partypancake8/4square_production/hardware/bom.csv

Comment | Designator | Footprint | LCSC Part #
PCA9548APW | U1 | TSSOP-24_4.4x7.8mm_P0.65mm | C130026
AP2112K-3.3 | U2 | SOT-23-5 | C51118
DS3231MZ+TRL | U4 | SOIC-8_3.9x4.9mm_P1.27mm | C107410
SHT31-DIS-B | U5 | Sensirion_DFN-8-1EP_2.5x2.5mm_P0.5mm_EP1.1x1.7mm | C80862
SN74AHCT1G125DBVR | U6 | SOT-23-5 | C7484
SRV05-4 | U7 | SOT-23-6 | C85364
GL5050RGB01H-W | D2 | LED_WS2812B_PLCC4_5.0x5.0mm_P3.2mm | C51933368
SMAJ5.0A-13-F | D3 | D_SMA | C87074
GL5050RGB01H-W | D4 | LED_WS2812B_PLCC4_5.0x5.0mm_P3.2mm | C51933368
GL5050RGB01H-W | D5 | LED_WS2812B_PLCC4_5.0x5.0mm_P3.2mm | C51933368
PolyFuse 750mA 1206L075/16WR | F1 | Fuse_1206_3216Metric | C371166
PT17-21C/L41/TR8 phototransistor | R7 | R_0805_2012Metric | C100090
1k 0603 | R8 | R_0603_1608Metric | C21190
1k 0603 | R9 | R_0603_1608Metric | C21190
1k 0603 | R10 | R_0603_1608Metric | C21190
1k 0603 | R11 | R_0603_1608Metric | C21190
470R 0603 | R12 | R_0603_1608Metric | C23179
10k 0603 1% | R13 | R_0603_1608Metric | C25804
10k 0603 1% | R14 | R_0603_1608Metric | C25804
100n 0603 | C1 | C_0603_1608Metric | C14663
10u 0805 | C2 | C_0805_2012Metric | C15850
10u 0805 | C3 | C_0805_2012Metric | C15850
10u 0805 | C4 | C_0805_2012Metric | C15850
100n 0603 | C5 | C_0603_1608Metric | C14663
100n 0603 | C6 | C_0603_1608Metric | C14663
100n 0603 | C7 | C_0603_1608Metric | C14663
100n 0603 | C8 | C_0603_1608Metric | C14663
22u 0805 | C9 | C_0805_2012Metric | C45783
100n 0603 | C10 | C_0603_1608Metric | C14663
100n 0603 | C11 | C_0603_1608Metric | C14663
100n 0603 | C12 | C_0603_1608Metric | C14663
100n 0603 | C13 | C_0603_1608Metric | C14663
100n 0603 | C14 | C_0603_1608Metric | C14663
22u 0805 | C15 | C_0805_2012Metric | C45783
100n 0603 | C16 | C_0603_1608Metric | C14663
100n 0603 | C17 | C_0603_1608Metric | C14663
10u 0805 | C18 | C_0805_2012Metric | C15850
