partypancake8/4square_production/case/4square-acrylic-back-reference.stl

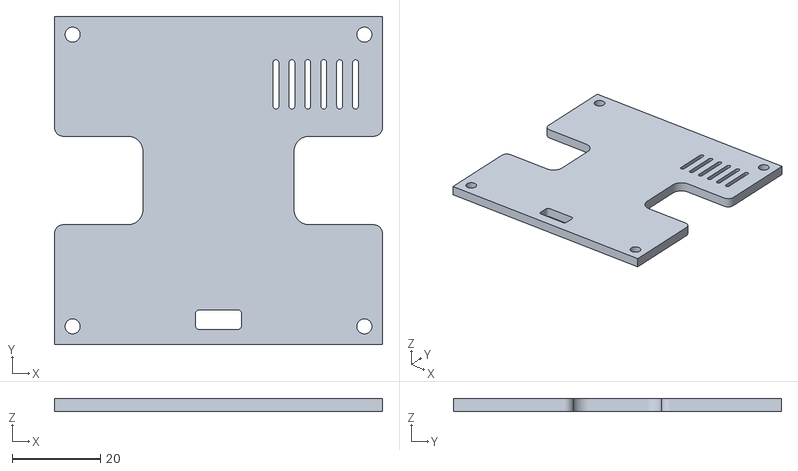
[picture p16: CAD file, 2026-10-29]
case/4square-acrylic-back-reference.stl
74.2 x 74.2 x 3.00
