partypancake8/4square_production/case/4square-shell.stl

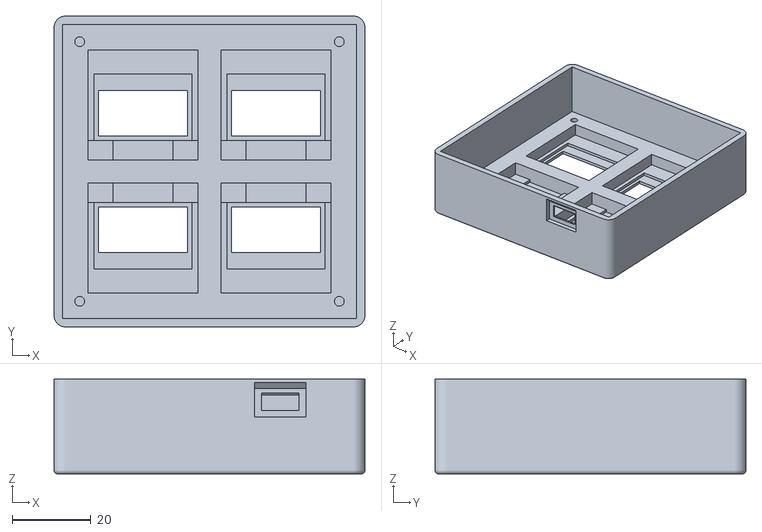
[picture p17: CAD file, 2026-10-29]
case/4square-shell.stl
79.1 x 79.1 x 24.1
