partypancake8/4square_production/case/4square-standoff-frame.stl

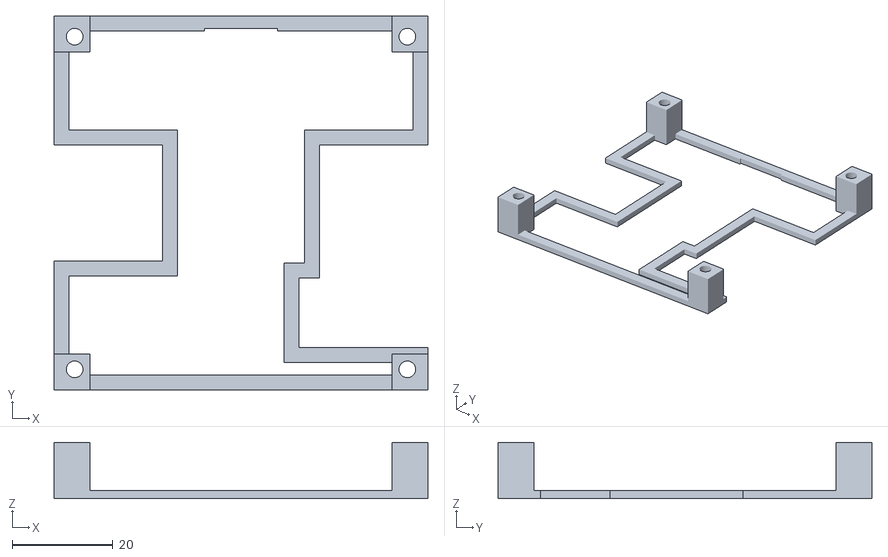
[picture p18: CAD file, 2026-10-29]
case/4square-standoff-frame.stl
74.2 x 74.2 x 11.1
