partypancake8/4square_production/case/4square-retainer-half-b.stl

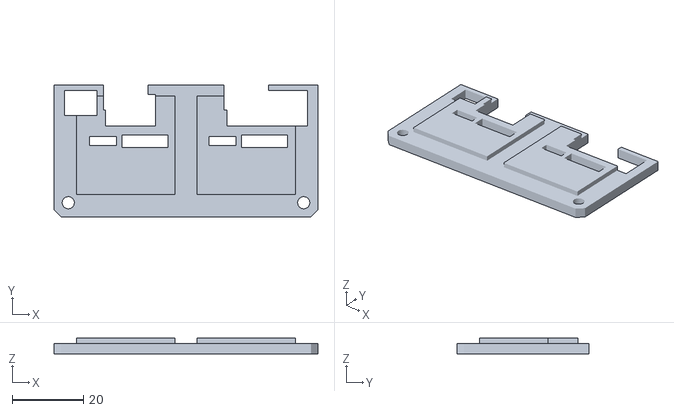
[picture p19: CAD file, 2026-10-29]
case/4square-retainer-half-b.stl
74.0 x 37.0 x 4.48
