partypancake8/4square_production/case/4square-acrylic-back.dxf

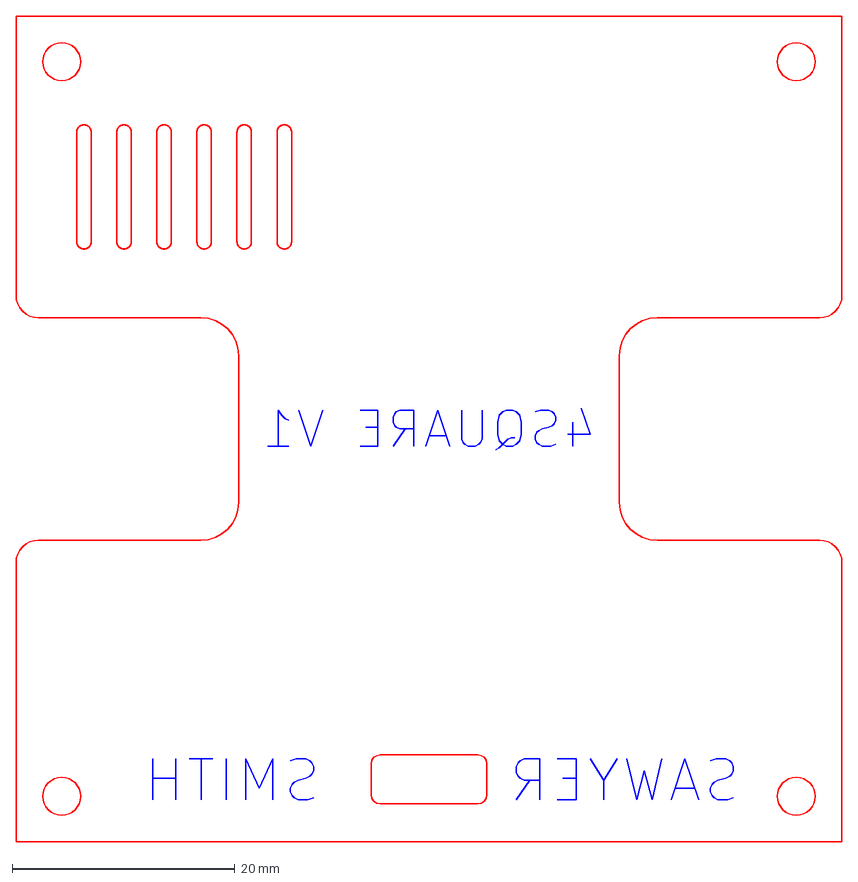
[picture p20: CAD file, 2026-10-29]
case/4square-acrylic-back.dxf
74.2 x 74.2 mm
