partypancake8/4square_production/case/4square-printed-back.stl

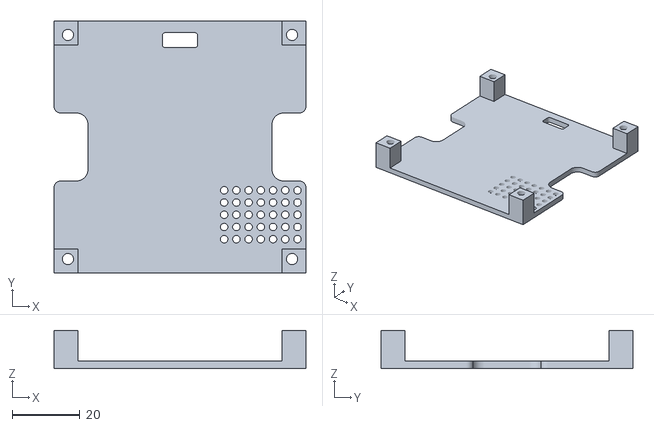
[picture p21: CAD file, 2026-10-29]
case/4square-printed-back.stl
74.2 x 74.2 x 11.2
