partypancake8/4square_production/(list of files, cad)

Other CAD files:
case/4square-retainer-half-a.stl
