partypancake8/4square_production/hardware/4square-revO-board.pdf

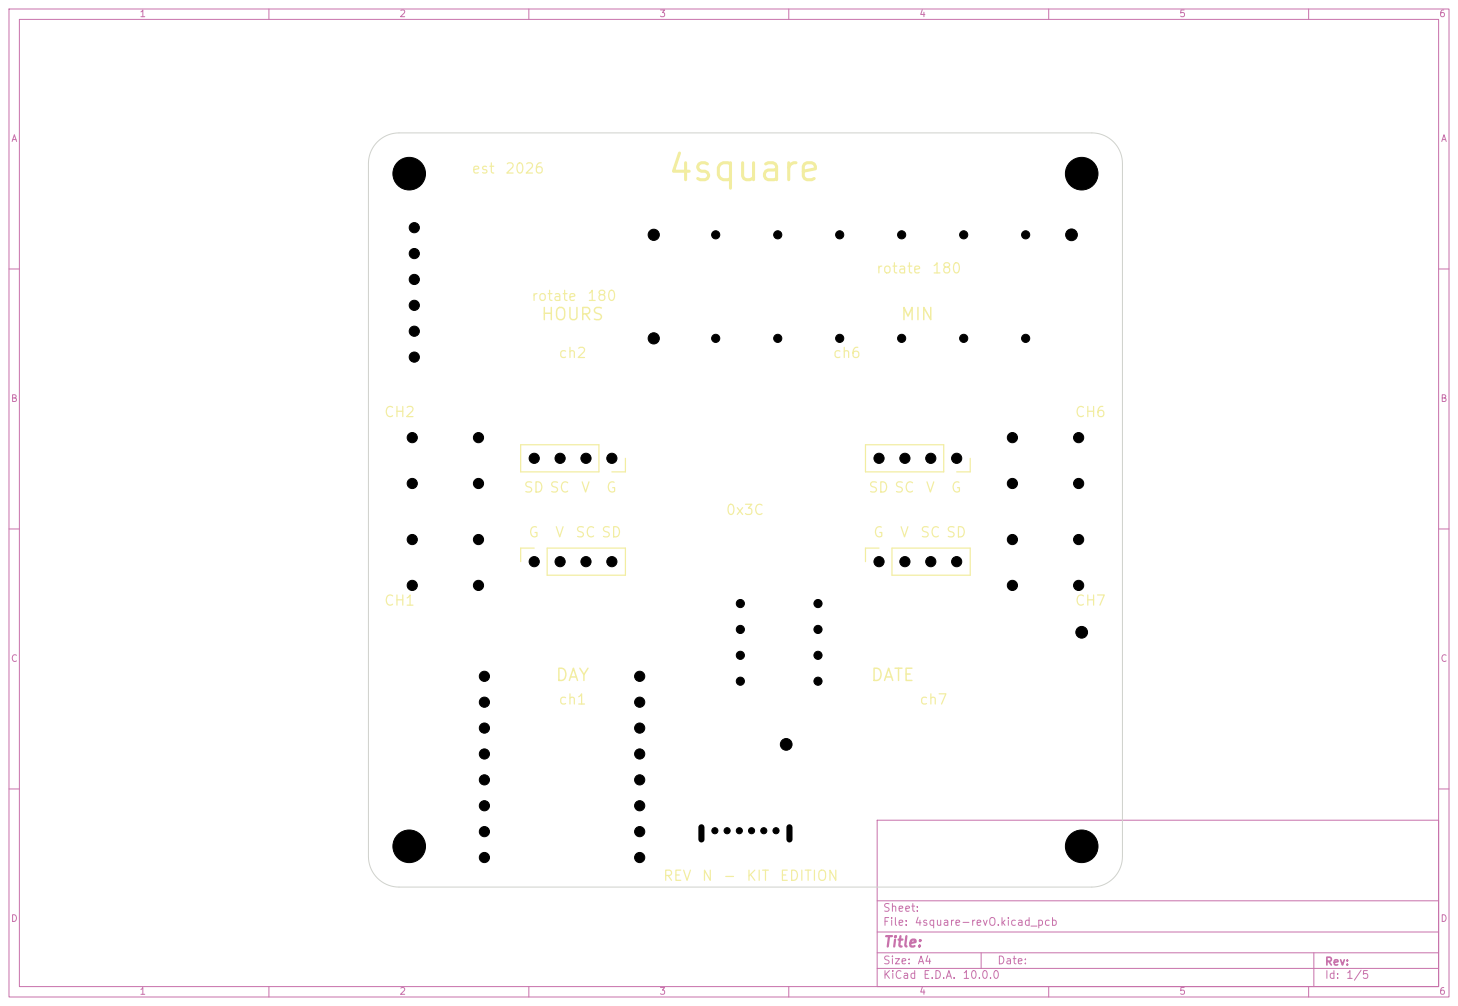
[picture p23: page 1]

Size: A4 | Rev:
KiCad E.D.A. 10.0.0 | Id: 1/5

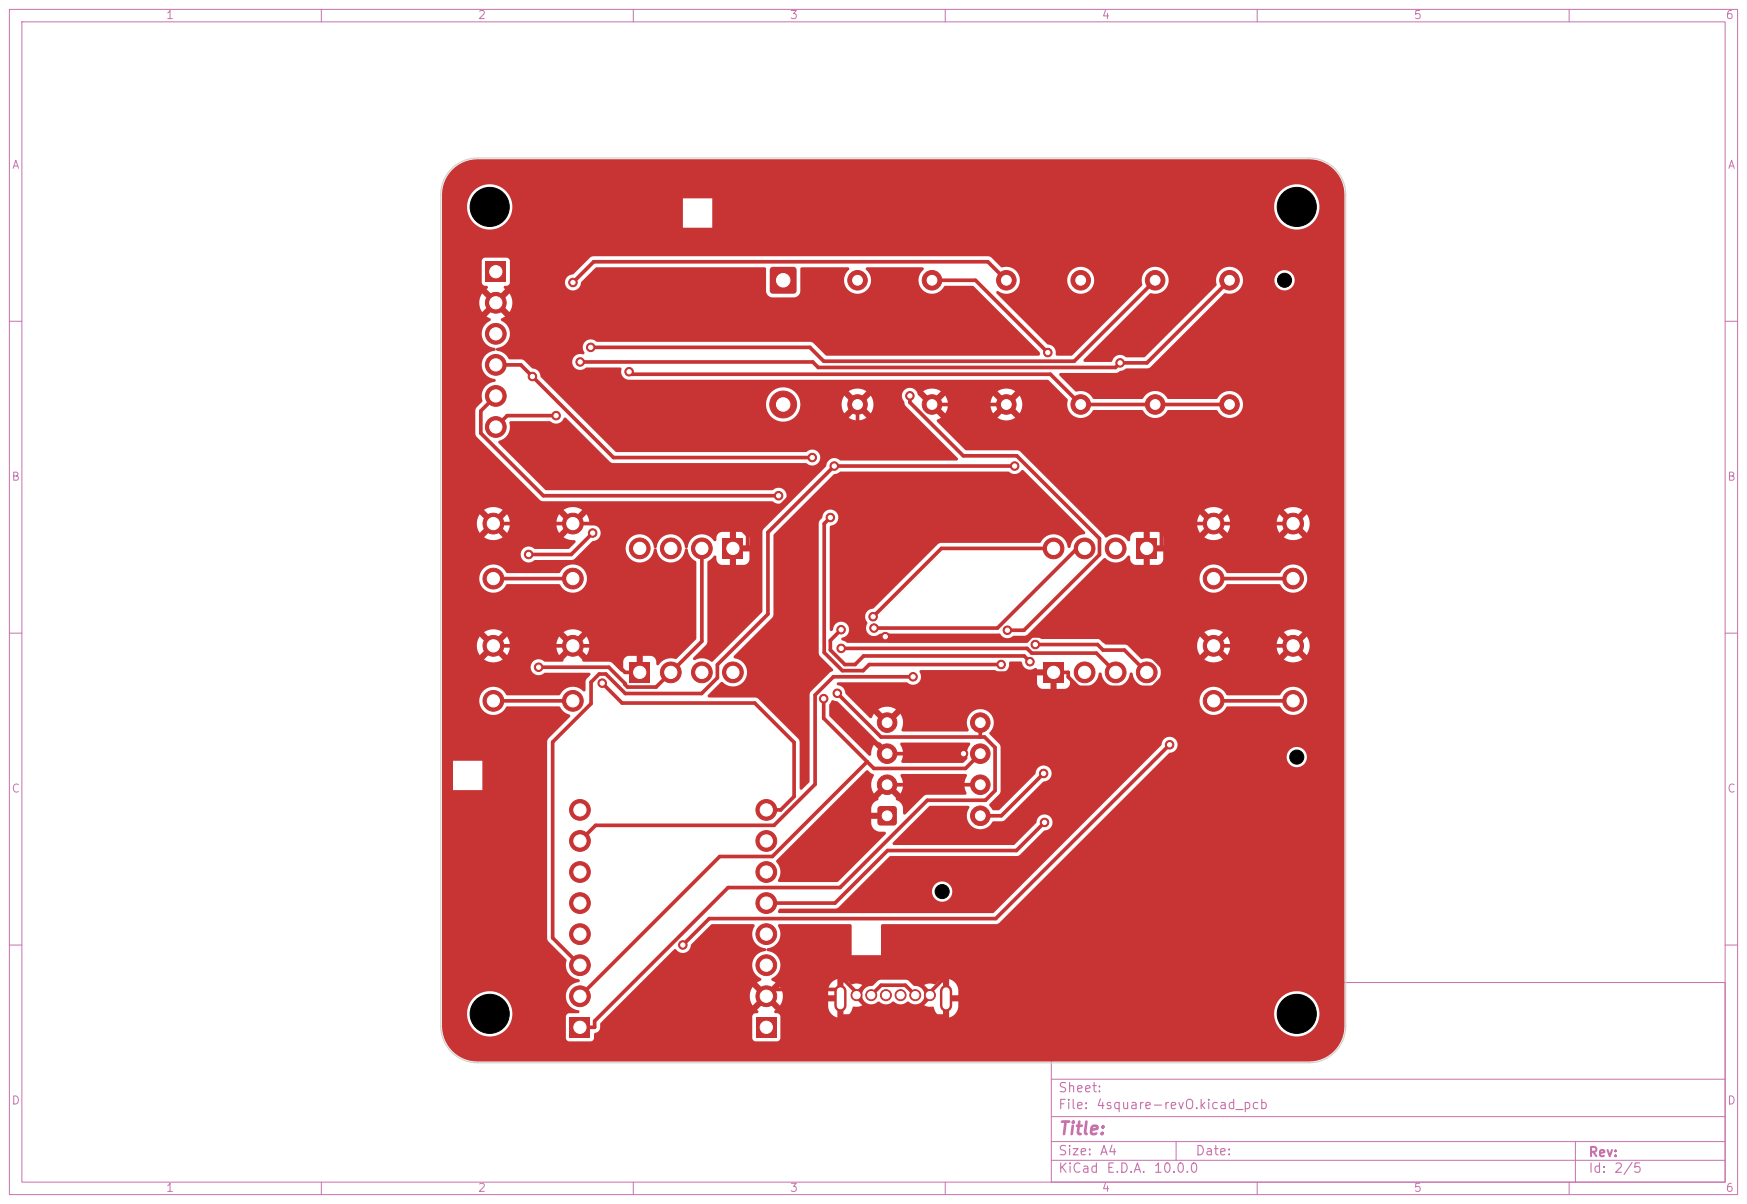
[picture p24: page 2]

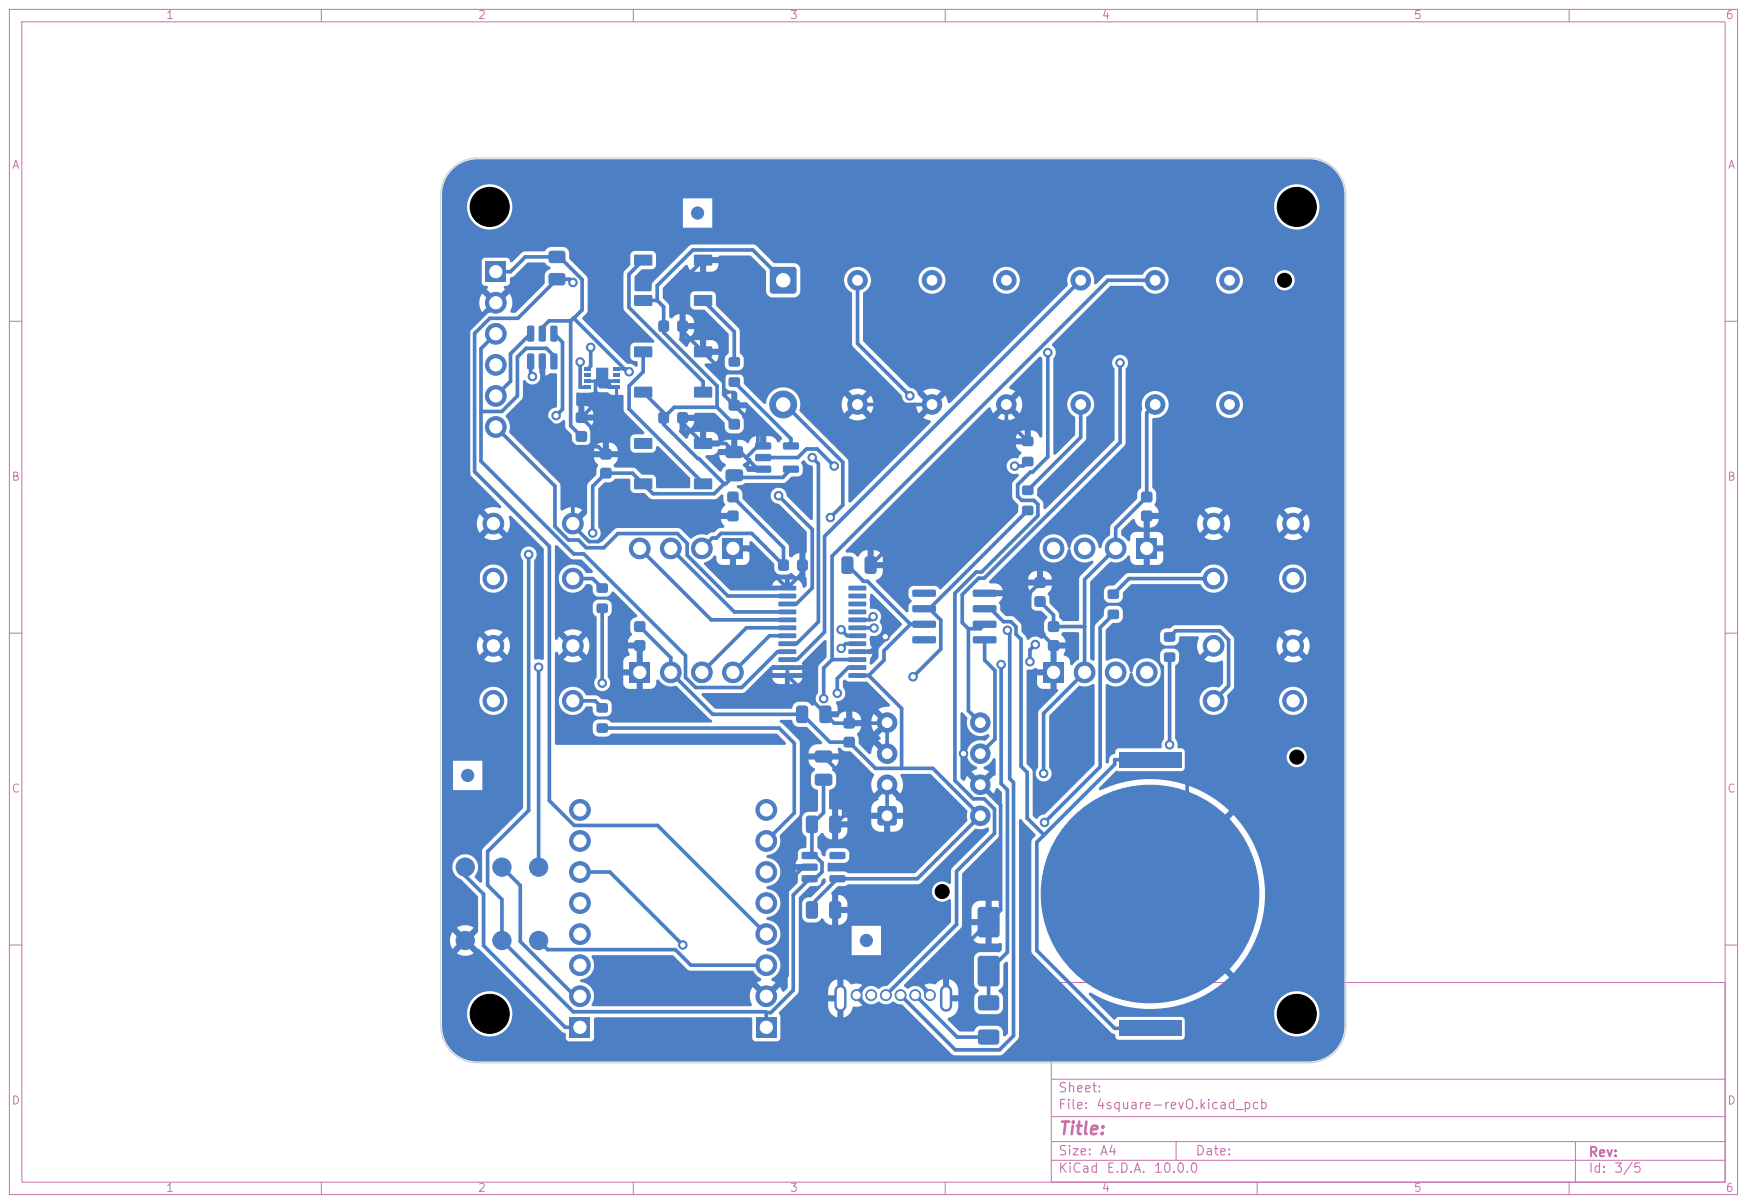
[picture p25: page 3]

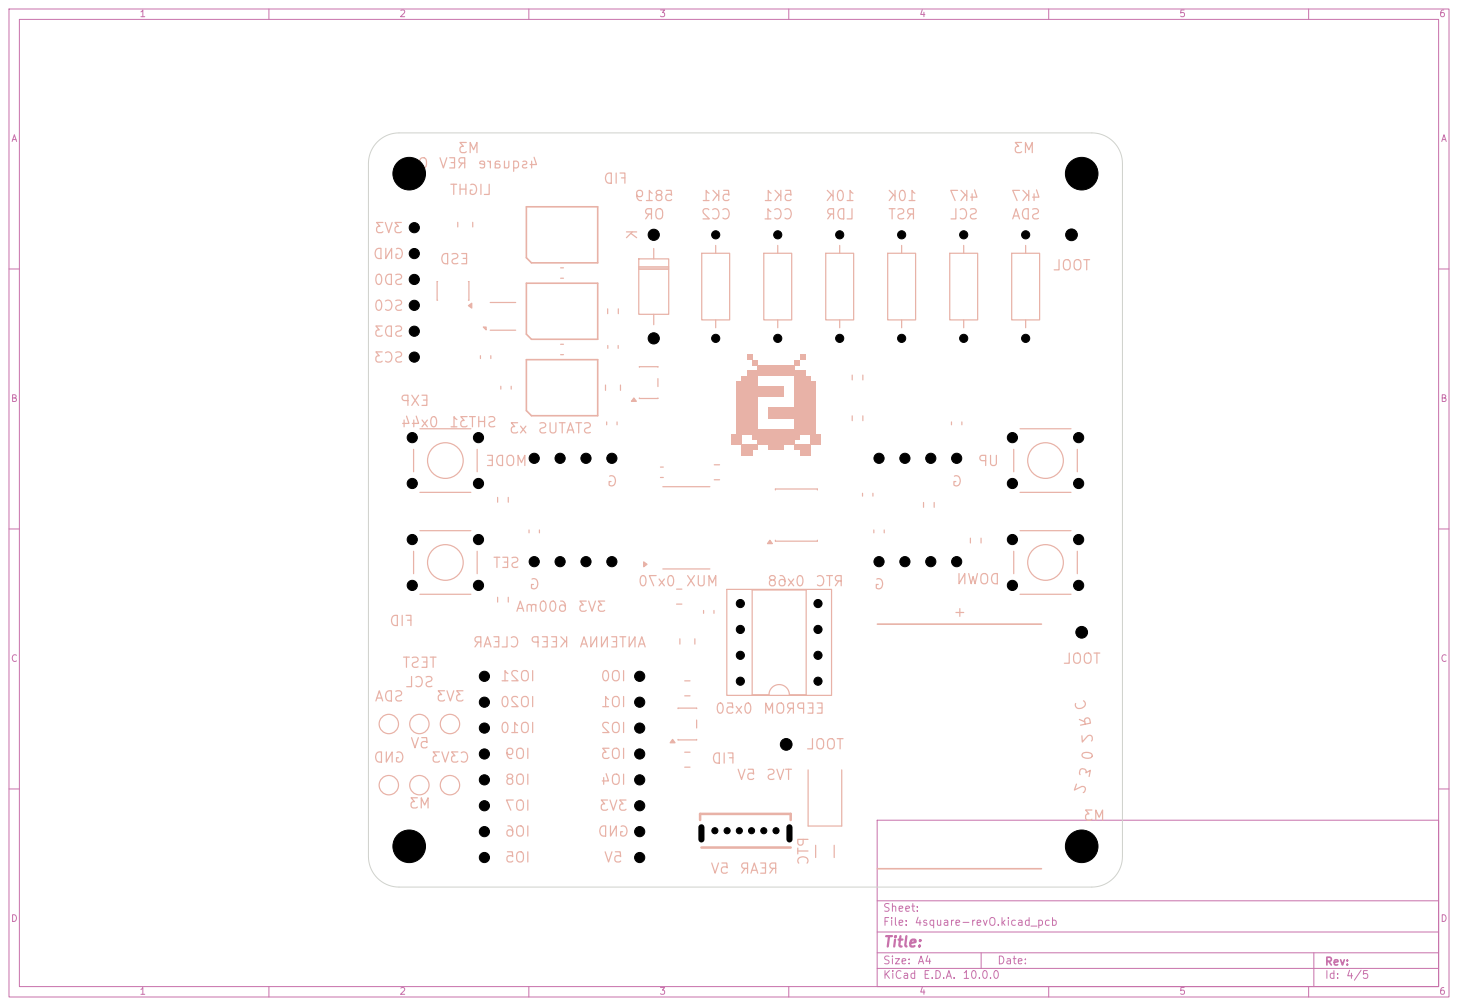
[picture p26: page 4]

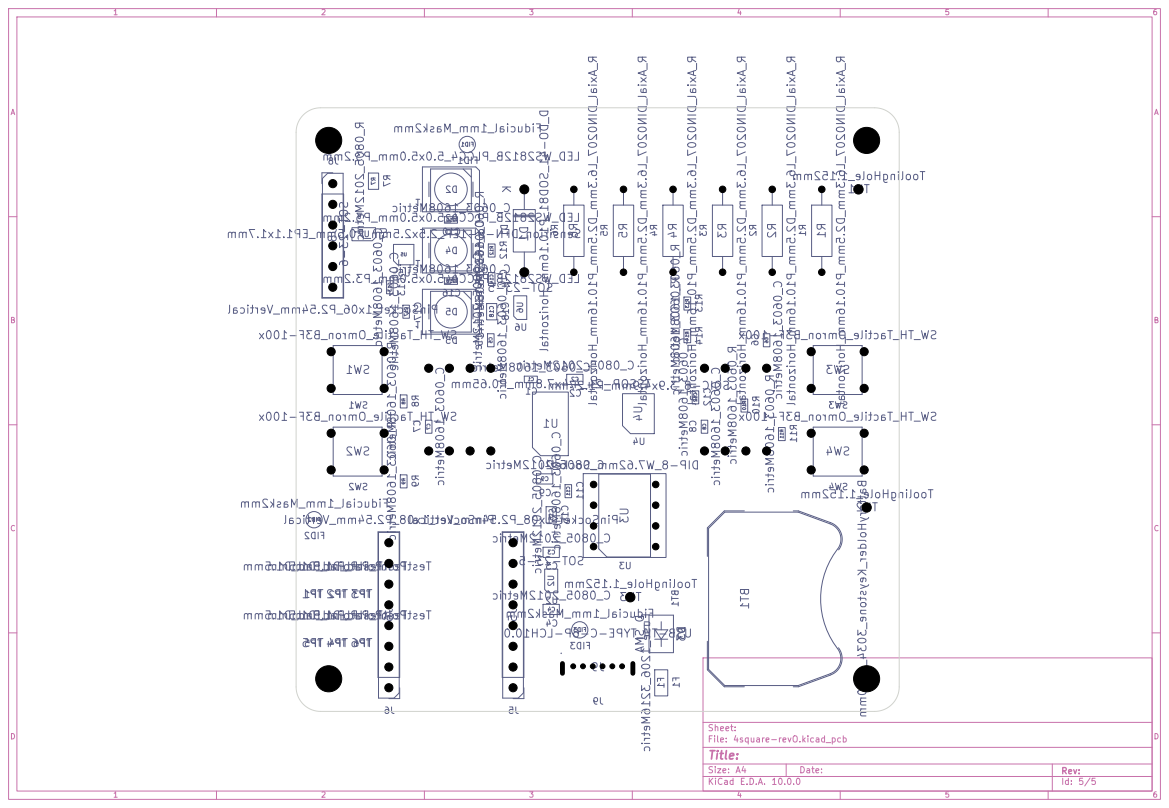
[picture p27: page 5]
