partypancake8/4square_production/hardware/kicad/4square-revO.kicad_pcb

## KiCad design hardware/kicad/4square-revO.kicad_pcb (2026-10-29)

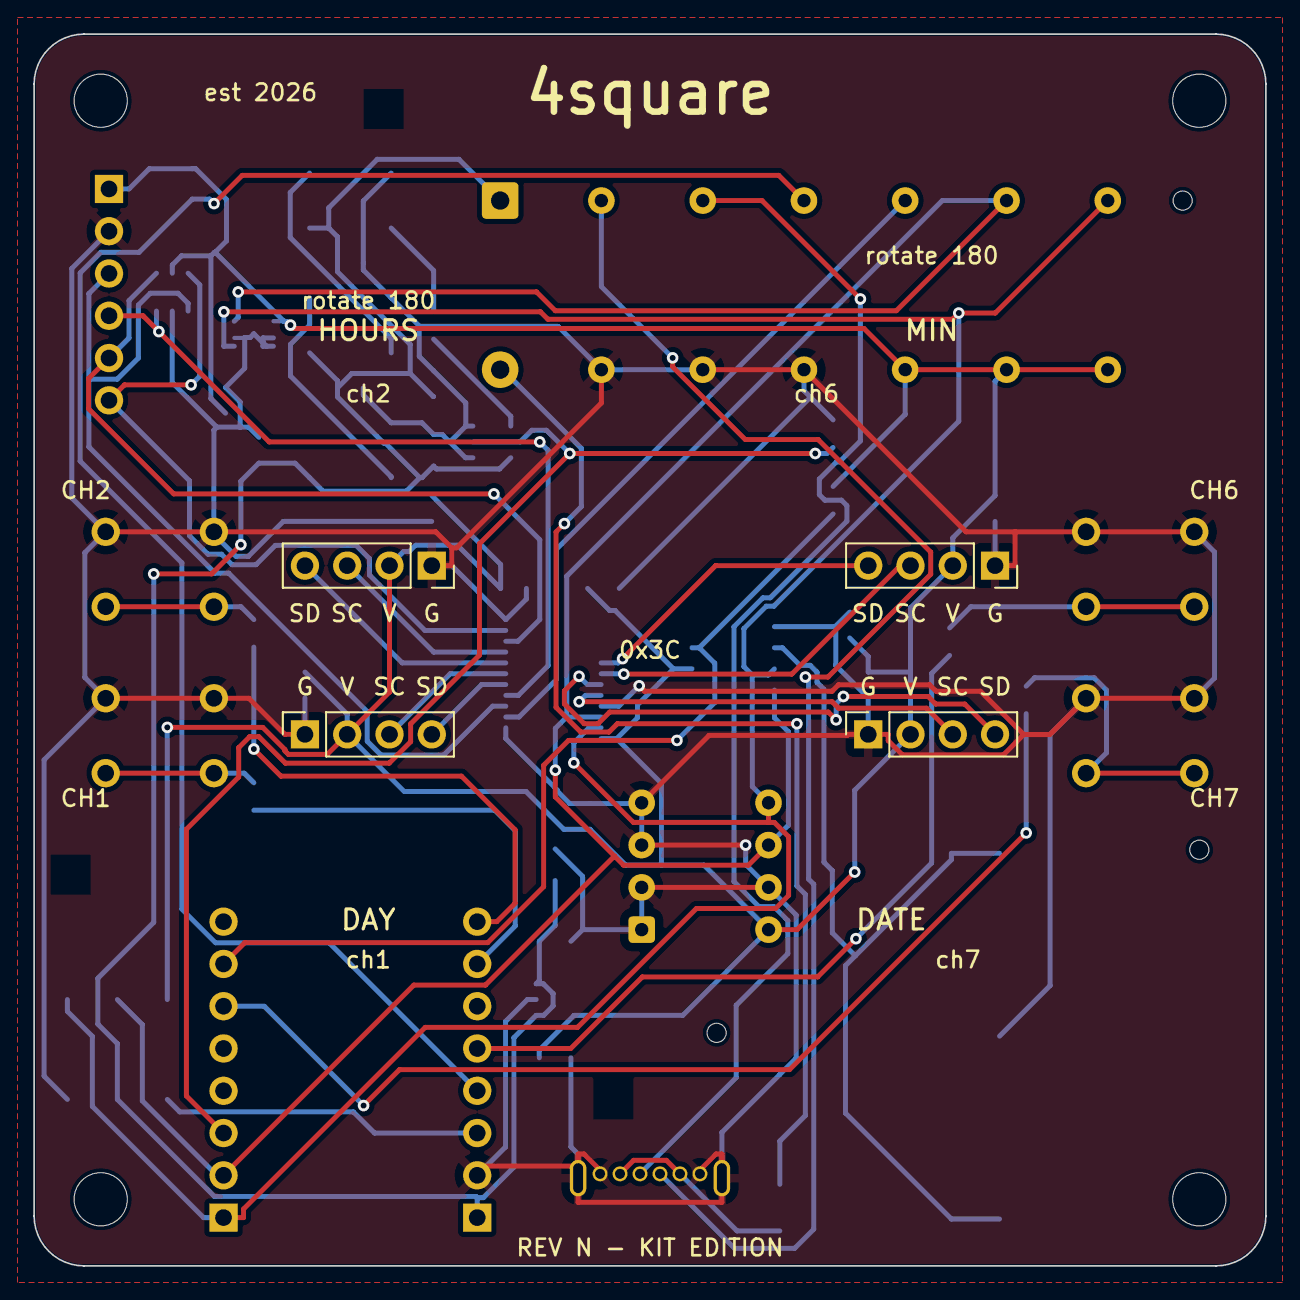
[picture p28: board 4square-revO.kicad_pcb from above]

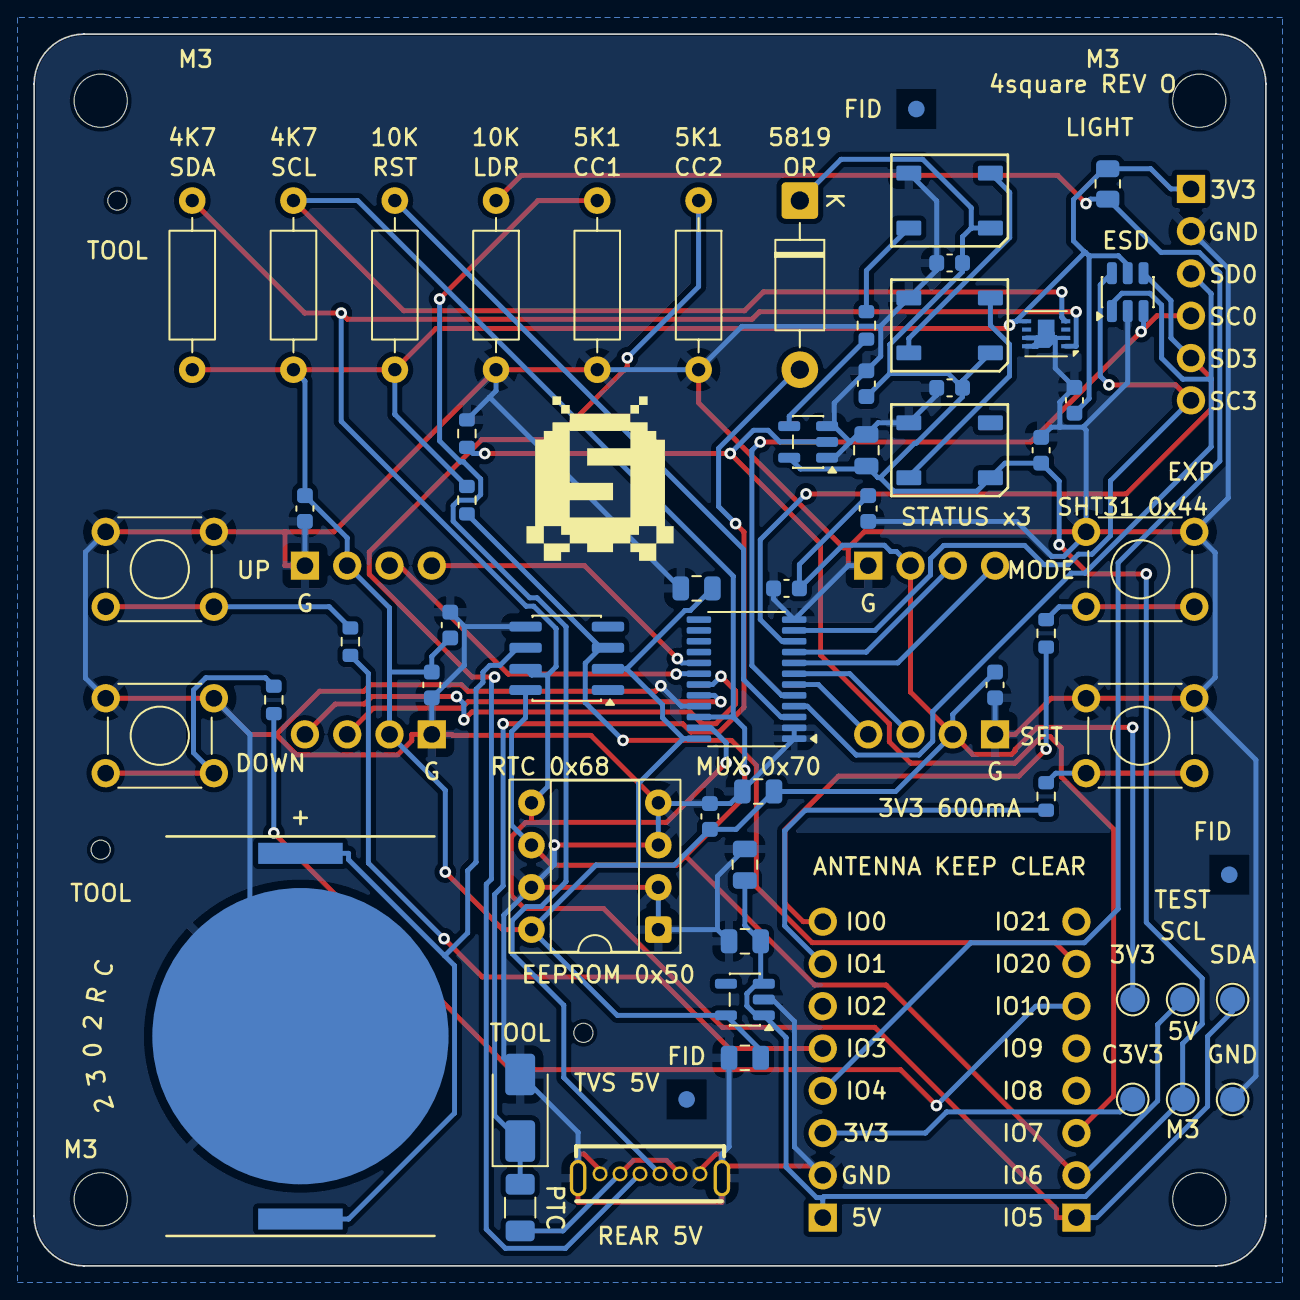
[picture p29: board 4square-revO.kicad_pcb from below]

Board: 2 copper layers, 74.0 x 74.0 mm, 74 parts (66 on the bottom side), 39 nets.

Parts:
BT1: BatteryHolder_Keystone_3034_1x20mm
C1, C5, C6, C7, C8, C10, C11, C12, C13, C14, C16, C17: C_0603_1608Metric
C2, C3, C4, C9, C15, C18: C_0805_2012Metric
D1: D_DO-41_SOD81_P10.16mm_Horizontal
D2, D4, D5: LED_WS2812B_PLCC4_5.0x5.0mm_P3.2mm
D3: D_SMA
F1: Fuse_1206_3216Metric
FID1, FID2, FID3: Fiducial_1mm_Mask2mm
H1, H2, H3, H4: MountingHole_3.2mm_M3
J1, J2, J3, J4: PinSocket_1x04_P2.54mm_Vertical
J5, J6: PinSocket_1x08_P2.54mm_Vertical
J8: PinSocket_1x06_P2.54mm_Vertical
J9: USB-TH_TYPE-C-6P-LCH10.0
R1, R2, R3, R4, R5, R6: R_Axial_DIN0207_L6.3mm_D2.5mm_P10.16mm_Horizontal
R7: R_0805_2012Metric
R8, R9, R10, R11, R12, R13, R14: R_0603_1608Metric
SW1, SW2, SW3, SW4: SW_TH_Tactile_Omron_B3F-100x
TH1, TH2, TH3: ToolingHole_1.152mm
TP1, TP2, TP3, TP4, TP5, TP6: TestPoint_Pad_D1.5mm
U1: TSSOP-24_4.4x7.8mm_P0.65mm
U2, U6: SOT-23-5
U3: DIP-8_W7.62mm_Socket
U4: SOIC-8_3.9x4.9mm_P1.27mm
U5: Sensirion_DFN-8-1EP_2.5x2.5mm_P0.5mm_EP1.1x1.7mm
U7: SOT-23-6

Connections:
+3V3: C1.1, C2.1, C4.1, C5.1, C6.1, C7.1, C8.1, C9.1, C11.1, C12.1, C13.1, J1.2, J2.2, J3.2, J4.2, J8.1, R1.2, R2.2, R3.2, R7.2, R14.2, TP3.1, U1.24, U2.5, U3.8, U4.2, U5.5, U7.5
+5V_VBUS: C3.1, C10.1, C14.1, C15.1, C16.1, C17.1, C18.1, D1.1, D2.1, D4.1, D5.1, J5.1, TP4.1, U2.1, U2.3, U6.5
BTN1: R8.2, SW1.1, SW1.3
BTN2: R9.2, SW2.1, SW2.3
BTN3: R10.2, SW3.1, SW3.3
BTN4: R11.2, SW4.1, SW4.3
C3_3V3: J5.3, TP6.1
CC1: J9.A5, R5.1
CC2: J9.B5, R6.1
GND: BT1.2, C1.2, C2.2, C3.2, C4.2, C5.2, C6.2, C7.2, C8.2, C9.2, C10.2, C11.2, C12.2, C13.2, C14.2, C15.2, C16.2, C17.2, C18.2, D2.3, D3.2, D4.3, D5.3, J1.1, J2.1, J3.1, J4.1, J5.2, J8.2, J9.7, J9.8, J9.A12, J9.B12, R4.2, R5.2, R6.2, R13.2, SW1.2, SW1.4, SW2.2, SW2.4, SW3.2, SW3.4, SW4.2, SW4.4, TP5.1, U1.1, U1.2, U1.12, U1.21, U2.2, U3.1, U3.2, U3.3, U3.4, U3.7, U4.5, U5.2, U5.7, U5.8, U5.9, U6.1, U6.3, U7.2
GPIO0: J5.8, R8.1
GPIO1: J5.7, R9.1
GPIO3: J5.5, R10.1
GPIO7: J6.3, R13.1, U6.2
GPIO10: J6.6, R11.1
GPIO20: J6.7, R14.1, U4.3
LDR_SENSE: J5.4, R4.1, R7.1
LED_CH1: D2.2, D4.4
LED_CH2: D4.2, D5.4
LED_DIN: D2.4, R12.2
LED_DRV: R12.1, U6.4
MUX_nRESET: R3.1, U1.3
SCL: J6.2, R2.1, TP2.1, U1.22, U3.6, U4.8, U5.4
SCL0: J8.4, U1.5, U7.3
SCL1: J3.3, U1.7
SCL2: J1.3, U1.9
SCL3: J8.6, U1.11, U7.6
SCL6: J2.3, U1.18
SCL7: J4.3, U1.20
SDA: J6.1, R1.1, TP1.1, U1.23, U3.5, U4.7, U5.1
SDA0: J8.3, U1.4, U7.1
SDA1: J3.4, U1.6
SDA2: J1.4, U1.8
SDA3: J8.5, U1.10, U7.4
SDA6: J2.4, U1.17
SDA7: J4.4, U1.19
VBAT: BT1.1, U4.6
VBUS_PROT: D1.2, D3.1, F1.2
VBUS_REAR: F1.1, J9.A9, J9.B9
