partypancake8/4square_production/(commit log)

2026-10-29 Firmware: stopwatch build replaces the market ticker
    UP is now a stopwatch (start, pause, clear) and the WiFi quote fetcher is
    gone. Brings in the current sketch, the layout and LED provers, the page
    renderer, and a layout prover gate plus --jobs 4 in build.sh.
    [anim.h, config.h, defaults.cpp, demo.h, display.cpp, faces.cpp, foursquare.ino]
2026-10-29 Hardware: rev O gerbers, BOM, CPL, kit list, board file and plots
    HARDWARE.md now describes the board that was ordered and built, with the
    full part list, pin map, mux channels and the silkscreen errata.
    ORDER-NOTES.md walks through the JLCPCB order and the placement checks.
    [4square-revO.kicad_pcb, bom.csv, kit-bom.csv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]
2026-10-29 Case: printable STLs, acrylic back DXF and the build123d sources
    Shell, retainer halves and printed back are case rev 5; the laser-cut
    acrylic back and its standoff frame are rev 6. The README covers print
    orientation, screws and the inside-face-up DXF.
    [4square-acrylic-back-reference.stl, 4square-acrylic-back.dxf, 4square-printed-back.stl, 4square-retainer-half-a.stl, 4square-retainer-half-b.stl, 4square-shell.stl, 4square-standoff-frame.stl]
2026-10-29 Docs: build guide, photos, board renders and the exploded view
2026-10-29 Hardware: one-table bill of materials for a whole clock
2026-10-29 Docs: tighten README and guides
2026-10-29 Docs: full-board renders, size-capped images
